stephenrjohnson/things/standingdesk-homeassistant/stl/lid.stl

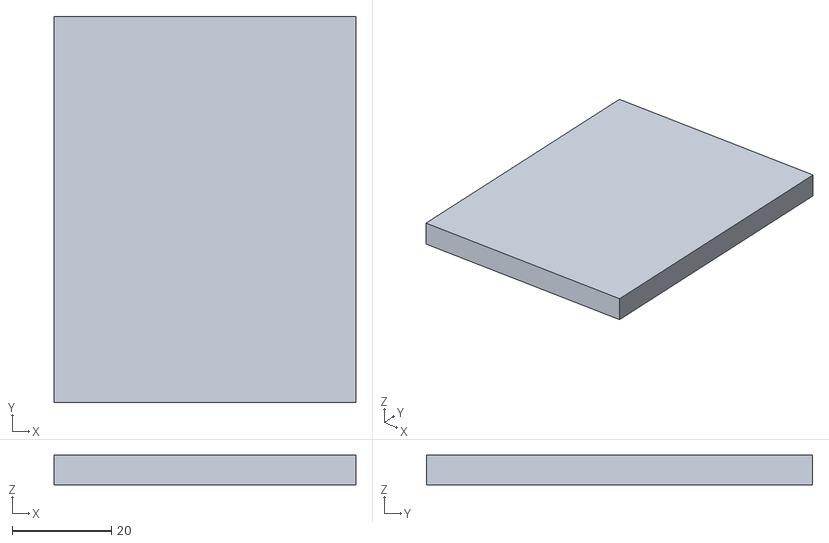
[picture p5: CAD file, 2025-11-13]
standingdesk-homeassistant/stl/lid.stl
61.0 x 78.0 x 6.00
