stephenrjohnson/things/standingdesk-homeassistant/stl/case.stl

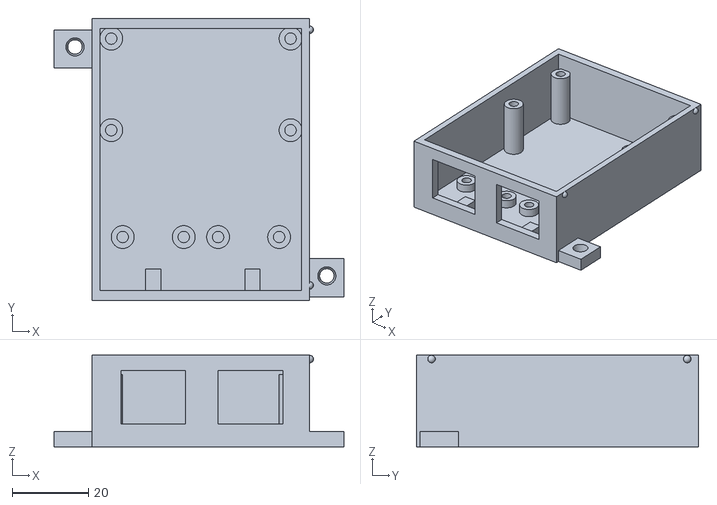
[picture p6: CAD file, 2025-11-13]
standingdesk-homeassistant/stl/case.stl
76.0 x 74.0 x 24.0
