stephenrjohnson/things/(commit log)

2025-11-13 feat: :sparkles: Upload the standing desk controller
    [case.stl, lid.stl]
2025-11-13 fix: :bug: Fix code path
    [sketch.yaml]
